vif802/stc32ESC/【文档】说明书 芯片手册 原理图 位号图等/代码审查报告.md

# STC32G 无刷电调代码审查报告

**审查日期：** 2026-03-10
**审查人：** Claude Code
**代码版本：** 逐飞科技 STC32G 无刷电调开源项目
**目标MCU：** STC32G12K128-LQFP48

---

## 一、项目架构评估

### 1.1 整体架构设计

| 评估项 | 评分 | 说明 |
|---|---|---|
| 模块化程度 | ⭐⭐⭐⭐☆ | 功能模块划分清晰，但存在文件命名冲突 |
| 代码组织结构 | ⭐⭐⭐☆☆ | 库文件和应用代码分层明确，但有命名重复问题 |
| 可维护性 | ⭐⭐⭐☆☆ | 注释较完整，但存在编码问题和魔法数字 |
| 安全性设计 | ⭐⭐⭐⭐☆ | 包含必要的保护机制（低压保护、堵转保护） |

### 1.2 目录结构

```
SEEKFREE_STC32G_BLDC/
├── bldc/                   # BLDC核心控制模块（良好）
│   ├── motor.c/h          # 电机控制核心
│   ├── pwm.c/h            # PWM生成
│   ├── comparator.c/h     # BEMF检测
│   ├── pwm_input.c/h      # 油门输入
│   ├── battery.c/h        # 电池监测
│   └── pit_timer.c/h      # 定时器/LED
├── Project/
│   ├── CODE/
│   │   ├── car_ctrl.c     # ⚠️ 智能车控制代码（与电调无关）
│   │   ├── motor.c/h      # ⚠️ 命名冲突！与 bldc/motor.c 重复
│   │   └── param_ctrl.c   # 参数控制
│   └── USER/src/
│       ├── main.c         # 主函数
│       └── isr.c          # 中断服务（部分为空）
└── Libraries/             # SDK和HAL库（标准）
```

### 1.3 严重问题：文件命名冲突

**问题描述：**
- `bldc/motor.c` 和 `Project/CODE/motor.c` 同时存在
- 两个文件都定义了 `motor_init()` 等函数
- 如果 include 路径配置不当，会导致链接错误或运行时错误

**影响程度：** 🔴 **高危**

**修复建议：**
```
方案1：将 Project/CODE/motor.c 重命名为 car_motor.c（智能车专用）
方案2：将 bldc/motor.c 重命名为 bldc_motor.c
方案3：删除 Project/CODE/ 下的智能车代码（如果只做电调）
```

---

## 二、核心模块详细审查

### 2.1 motor.c - 电机控制核心

**文件位置：** `bldc/motor.c`
**代码行数：** ~818行
**功能：** 实现三段式无传感器启动（预定位→开环→闭环）

#### ✅ 优点

1. **启动策略完善**
   - 实现了标准的三段式启动：预定位(Alignment) → 开环加速(Open-loop) → 闭环运行(Closed-loop)
   - 支持三种加速曲线：线性、指数、S曲线
   - 有过渡阶段确保平滑切换

2. **安全保护机制**
   ```c
   // 堵转检测 - 使用换相时间方差判断
   if(((max >> 1) > average) || ((min << 1) < average) || (15000 < max) || (100 > min))
   {
       motor.commutation_failed_num++;
   }

   // 超时保护 - Timer4检测换相超时
   if(BLDC_COMMUTATION_FAILED_MAX < motor.commutation_failed_num)
   {
       motor_stop();
       motor.restart_delay = BLDC_START_DELAY;
   }
   ```

3. **占空比斜坡控制**
   ```c
   void duty_ramp_up(void)  // 避免电流冲击
   ```

#### ⚠️ 问题与风险

**问题1：代码重复（低效）**

```c
// motor_max_min_pwm() 和 motor_max_min_comparator() 功能完全相同
void motor_max_min_pwm(uint16 *dat, uint8 length, uint16 *max, uint16 *min);      // 第179行
void motor_max_min_comparator(uint16 *dat, uint8 length, uint16 *max, uint16 *min); // 第209行
```

**建议：** 合并为一个函数 `motor_find_max_min()`

---

**问题2：魔法数字过多**

```c
// 第480-494行：这些数字缺乏注释说明
if(((max >> 1) > average) || ((min << 1) < average) || (15000 < max) || (100 > min))

// 第513行：65535 - average/4 的含义不明确
timer0_reconfig(65535 - average/4);

// 第627行：为什么用 %6 判断？
if(0 == (motor.commutation_num%6))
```

**建议：** 定义为有意义的常量
```c
#define COMMUTATION_TIME_MAX    15000   // 最大换相时间(us)
#define COMMUTATION_TIME_MIN    100     // 最小换相时间(us)
#define DEMAGNETIZATION_DIV     4       // 消磁时间分频系数
```

---

**问题3：潜在的除零风险**

```c
// 第480-482行
if((max > 0) && (min > 0))
{
    err_percent = ((max - min) * 100) / ((max + min) >> 1);  // 如果 max+min < 2，右移后=0，除零！
```

**风险：** 当 `max=0, min=1` 时，`(max+min) >> 1 = 0`，导致除零错误。

---

**问题4：死代码**

```c
// 第472-490行：这些变量计算后未实际使用
uint8 zc_quality_ok = 0;
uint16 err_percent = 0;
...
(void)zc_quality_ok;  // 显式标记已使用，消除警告
(void)err_percent;
```

说明：这段代码用于过零信号质量检测，但实际切换逻辑在TM3_Isr中。这是未完成的调试代码。

---

**问题5：启动阶段状态机不够清晰**

```c
// run_flag 和 start_phase 两个变量都表示阶段，容易混淆
motor.run_flag = 2;       // 开环加速阶段
motor.start_phase = 2;    // 同样表示开环阶段
```

**建议：** 统一使用一个状态变量

---

### 2.2 pwm.c - PWM生成

**文件位置：** `bldc/pwm.c`
**代码行数：** ~279行

#### ✅ 优点

1. **死区控制正确**
   ```c
   void pwm_a_bn_output(void)
   {
       pwm_close_output();   // 先关闭所有输出
       delay_500ns();        // 500ns死区延时
       PWMA_ENO = 1<<0;      // 再开启新的相
       PWM_B_L_PIN = 1;
       comparator_select_c(); // 同步切换比较器通道
   }
   ```

2. **中心对齐PWM配置正确**
   - 使用 PWM Mode 2
   - 预装载允许，避免PWM glitch

#### ⚠️ 问题与风险

**问题1：软延时不精确**

```c
void delay_500ns(void)
{
    _nop_();  // 8个nop，假设每个nop 62.5ns（16MHz），实际是500ns
    ...
}
```

**风险：** 系统频率改为33MHz后，实际延时变为约240ns，死区不足可能导致上下桥直通！

**建议：** 根据实际主频调整nop数量，或使用定时器实现精确延时。

---

**问题2：占空比更新方式有风险**

```c
void pwm_center_duty_update(uint16 duty)
{
    duty = BLDC_MAX_DUTY - duty;  // 反相计算
    // 直接更新CCR寄存器
    PWMA_CCR1H = temp_h;
    ...
}
```

**风险：** 在PWM周期中更新CCR可能导致glitch（毛刺）。

**建议：** 利用预装载机制，在PWM更新事件时自动加载新值。

---

### 2.3 comparator.c - BEMF检测

**文件位置：** `bldc/comparator.c`
**代码行数：** ~110行

#### ✅ 优点

1. **比较器配置正确**
   ```c
   CMPCR2 = 63;  // 63个时钟滤波，避免噪声干扰
   ```

2. **通道切换清晰**
   - 根据当前换相步骤切换比较器输入通道

#### ⚠️ 问题与风险

**问题1：中文注释严重乱码**

```c
// 第14行
//  @brief      姣旇緝鍣ㄩ€夋嫨A閫氶亾涓鸿緭鍏?
```

虽然不影响编译，但严重影响代码可读性。

---

### 2.4 pwm_input.c - 油门输入

**文件位置：** `bldc/pwm_input.c`
**代码行数：** ~110行

#### ✅ 优点

1. **输入信号校验完善**
   ```c
   // 频率检查：30-400Hz
   if((30 < pwmin.frequency) && (400 > pwmin.frequency))

   // 脉宽检查：1000-2000us
   if((3000 < pwmin.high_time) || (1000 > pwmin.high_time))
   ```

2. **分频系数设计合理**
   - PSC=32，使得计数值直接对应us（近似）

#### ⚠️ 问题与风险

**问题1：信号丢失处理有延迟**

```c
if(PWMB_SR1 & 0x01)  // 更新中断（信号丢失）
{
    PWMB_SR1 = 0;
    pwmin.throttle = 0;
    motor.duty = 0;  // 直接清零，可能导致电机突然停止
}
```

**风险：** PWM信号突然丢失时电机会立即停转，可能造成危险。

**建议：** 增加信号丢失超时检测，逐渐降低占空比。

---

**问题2：油门阈值计算有歧义**

```c
// 第59行
if(temp < ((uint32)1000 * BLDC_MIN_DUTY / BLDC_MAX_DUTY))
{
    temp = 0;
}
```

**问题：** 将占空比直接映射到油门阈值不合理，应该设置独立的油门死区参数。

---

### 2.5 battery.c - 电池监测

**文件位置：** `bldc/battery.c`
**代码行数：** ~57行

#### ✅ 优点

1. **分压电阻计算正确**
   ```c
   battery_voltage = (uint32)pin_voltage * 57 / 10;  // 分压比5.7:1
   ```

2. **低电压滤波处理**
   ```c
   // 连续100次检测到低电压才触发保护
   if(100 < low_power_num)
   ```

#### ⚠️ 问题与风险

**问题1：缺少过压保护**

只有低压保护，没有高压保护。如果误接6S电池到3S电调，可能损坏硬件。

---

**问题2：电压校准值硬编码**

```c
pin_voltage = (uint32)adc_value * 5000 / 256;  // 假设Vref=5V
```

**风险：** 实际Vref可能有偏差，应该支持校准。

---

### 2.6 pit_timer.c - 定时器/LED

**文件位置：** `bldc/pit_timer.c`
**代码行数：** ~146行

#### ✅ 优点

1. **LED状态指示清晰**
   - 不同run_flag对应不同闪烁模式
   - 便于调试和故障排查

2. **自动启动逻辑正确**
   ```c
   if(motor.duty && (0 == motor.run_flag))
   {
       motor_start();  // 有油门且电机停止时才启动
   }
   ```

#### ⚠️ 问题与风险

**问题1：中文注释严重乱码**

与comparator.c类似，编码问题导致注释不可读。

---

**问题2：停止逻辑有漏洞**

```c
else if((0 == motor.duty) && ((3 == motor.run_flag) || (4 == motor.run_flag)))
{
    motor_stop();  // 只在run_flag=3或4时停止
}
```

**风险：** 如果电机在启动阶段(run_flag=1或2)油门归零，不会立即停止。

**建议：**
```c
else if(0 == motor.duty)
{
    motor_stop();  // 只要有油门就停止，无论哪个阶段
}
```

---

## 三、应用层代码审查（Project/CODE/）

### 3.1 car_ctrl.c - 智能车控制

**状态：** ⚠️ **与BLDC电调功能无关**

这个文件实现的是智能车竞赛的控制逻辑：
- 编码器测速
- 速度PID
- 角速度PID
- 转向PID

**问题：** 这是智能车主控板的代码，不应该出现在无刷电调项目中。

**建议：** 如果只做电调，删除整个 Project/CODE/ 目录。

---

### 3.2 Project/CODE/motor.c

**状态：** ⚠️ **命名冲突**

这个文件实现的是智能车的直流电机控制（有刷电机），与 `bldc/motor.c` 完全不同。

**函数冲突列表：**
- `motor_init()` - 两者都有
- `motor_control()` - 两者都有

**风险：** 链接时可能链接错误的函数，导致电调无法工作。

---

## 四、编码质量问题汇总

### 4.1 严重问题（必须修复）

| 优先级 | 问题 | 位置 | 修复建议 |
|---|---|---|---|
| 🔴 P0 | 文件命名冲突 | Project/CODE/motor.c vs bldc/motor.c | 重命名其中一个 |
| 🔴 P0 | 死区延时不准确 | pwm.c:17 | 根据33MHz调整nop数量 |
| 🟡 P1 | 除零风险 | motor.c:482 | 增加除零保护 |
| 🟡 P1 | 停止逻辑漏洞 | pit_timer.c:108 | 修复为所有阶段都能停止 |

### 4.2 中等问题（建议修复）

| 优先级 | 问题 | 位置 | 修复建议 |
|---|---|---|---|
| 🟡 P1 | 代码重复 | motor.c:179,209 | 合并函数 |
| 🟡 P1 | 魔法数字 | motor.c:480-494 | 定义为常量 |
| 🟡 P1 | 死代码 | motor.c:472-490 | 删除或完成逻辑 |
| 🟢 P2 | 注释乱码 | 多处 | 重新保存为UTF-8 |

### 4.3 轻微问题（可选优化）

| 优先级 | 问题 | 位置 | 修复建议 |
|---|---|---|---|
| 🟢 P2 | 缺少过压保护 | battery.c | 增加高压检测 |
| 🟢 P2 | 信号丢失处理 | pwm_input.c:71 | 增加平滑过渡 |
| 🟢 P2 | 状态机重复 | motor.h | 统一状态变量 |

---

## 五、功能正确性评估

### 5.1 启动流程验证

```
[停止] → 预定位(Alignment) → 开环加速(Open-loop) → 过渡 → 闭环(Closed-loop)
   ↑                                                    ↓
   └──────────────── 堵转/停止 ──────────────────────────┘
```

**状态转换检查：** ✅ 逻辑正确

### 5.2 中断优先级配置

```c
// motor.c:807-812
IP |= 1<<7;     // 比较器中断 - 高优先级
IPH |= 1<<7;
IP2 |= 1<<5;    // PWM中断 - 高优先级
IP2H |= 1<<5;
```

**评估：** ✅ 关键中断（PWM、比较器）优先级正确

### 5.3 换相时序验证

换相表检查（6步换相）：
| Step | 上桥 | 下桥 | 检测相 | 沿 |
|---|---|---|---|-----|
| 0 | A | B | C | 下降沿 |
| 1 | A | C | B | 上升沿 |
| 2 | B | C | A | 下降沿 |
| 3 | B | A | C | 上升沿 |
| 4 | C | A | B | 下降沿 |
| 5 | C | B | A | 上升沿 |

**评估：** ✅ 换相表正确，BEMF检测相和沿匹配

---

## 六、性能评估

### 6.1 中断响应时间

| 中断源 | 优先级 | 执行时间(估算) | 风险 |
|---|---|---|---|
| PWM中断 | 高 | ~50us | 高频中断，占用较多CPU |
| 比较器中断 | 高 | ~30us | 只在闭环触发，可接受 |
| Timer1(10ms) | 低 | ~10us | 可接受 |
| Timer3 | 低 | ~20us | 只在启动触发，可接受 |

**评估：** 33MHz主频下，中断负载率约10-15%，可接受。

### 6.2 内存使用

```
Program Size: data=8.0 edata+hdata=1154 xdata=0 const=189 code=11613
```

- CODE: ~11.6KB (STC32G12K128有128KB Flash，充足)
- DATA: ~1.2KB (STC32G12K128有8KB RAM，充足)

**评估：** ✅ 资源使用合理

---

## 七、安全评估

### 7.1 硬件保护措施

| 保护功能 | 实现状态 | 评估 |
|---|---|---|
| 低压保护 | ✅ 已实现 | 10V阈值，100次滤波 |
| 过压保护 | ❌ 未实现 | 建议增加 |
| 过流保护 | ❌ 未实现 | 硬件需增加电流检测 |
| 堵转保护 | ✅ 已实现 | 基于换相时间方差 |
| 过热保护 | ❌ 未实现 | 需增加温度检测 |
| 启动超时 | ✅ 已实现 | BLDC_START_WAIT_TIME |

### 7.2 PWM安全

```c
// main.c:61-64 重要提醒！
// PWM初始化务必放在电机电机初始化函数之后，否则会烧毁电机
pwm_center_init();
```

**评估：** ✅ 初始化顺序要求明确，防止硬件损坏

---

## 八、可改进建议（优化方向）

### 8.1 代码优化

1. **使用查找表优化加速曲线**
   ```c
   // 当前：实时计算 Sigmoid
   delay = START_OPEN_LOOP_MIN_DELAY + ... * 1.0f/(1.0f + exp(...));

   // 优化：预计算查找表
   const uint16 accel_curve[100] = { ... };
   ```

2. **减少浮点运算**
   - 当前代码使用较多float运算
   - 定点数或整数运算可提升性能

### 8.2 功能扩展

1. **增加反向功能**
   - 当前只支持单向旋转
   - 可增加方向控制输入

2. **增加刹车模式**
   - 当前只有自由停车
   - 可增加能耗刹车或反接刹车

3. **增加参数可调**
   - 通过串口或按键调整PID参数
   - 实时修改启动曲线

---

## 九、测试建议

### 9.1 单元测试

| 测试项 | 测试方法 | 通过标准 |
|---|---|---|
| 预定位时间 | 示波器测量 | 与START_ALIGN_TIME_MS一致 |
| 开环加速曲线 | 逻辑分析仪 | 换相间隔逐渐减小 |
| 闭环切换 | 虚拟示波器 | zc_detect_count达到设定值后切换 |
| 堵转保护 | 手动堵转电机 | 150次错误后停止 |
| 低压保护 | 可调电源 | 10V以下停止，10.5V以上恢复 |

### 9.2 集成测试

1. **不同电机测试**
   - 不同KV值电机
   - 不同极对数电机

2. **不同负载测试**
   - 空载启动
   - 带载启动
   - 突加负载

3. **边界条件测试**
   - 最低启动电压
   - 最高工作电压
   - 最低/最高油门

---

## 十、总结

### 总体评价

| 维度 | 评分 | 说明 |
|---|---|---|
| 功能完整性 | ⭐⭐⭐⭐☆ | 三段式启动完善，保护功能齐全 |
| 代码质量 | ⭐⭐⭐☆☆ | 有编码问题和重复代码 |
| 安全性 | ⭐⭐⭐⭐☆ | 必要的保护都有，但缺少过压/过流 |
| 可维护性 | ⭐⭐⭐☆☆ | 需要解决命名冲突和注释问题 |
| 性能 | ⭐⭐⭐⭐☆ | 中断负载合理，资源使用合理 |

### 是否可以运行

**结论：** ✅ **可以运行，但需要先修复关键问题**

**必须修复后才能运行：**
1. 文件命名冲突（Project/CODE/motor.c）
2. 死区延时调整（pwm.c）

**建议修复：**
3. 除零风险（motor.c）
4. 停止逻辑漏洞（pit_timer.c）

### 是否符合项目规划

**评估：** ✅ 基本符合无刷电调的功能规划

**注意：** Project/CODE/ 目录下的智能车代码与电调功能无关，建议移除以避免混淆。

---

**报告结束**

如有任何疑问或需要针对特定问题的详细修复方案，请随时提出。
