vif802/stc32ESC/【文档】说明书 芯片手册 原理图 位号图等/编码转换问题修复记录.md

# 编码转换问题修复记录

## 问题概述

在使用 VSCode 进行文件编码格式转换时，由于处理不当导致源代码文件出现严重损坏，造成 Keil 编译失败。

**根本原因：** GBK 编码的中文注释被错误转换后，换行符丢失，导致代码结构被破坏。

---

## 错误现象

### 编译错误信息

```
compiling motor.c...
..\..\bldc\motor.c(85): error C70: duty_ramp_timer: undefined member
..\..\bldc\motor.c(86): error C70: duty_ramp_timer: undefined member
..\..\bldc\motor.c(88): error C70: duty_ramp_timer: undefined member
..\..\bldc\motor.c(338): error C70: start_phase: undefined member
..\..\bldc\motor.c(340): error C70: duty_ramp_timer: undefined member
..\..\bldc\motor.c(572): error C25: syntax error near 'void'
...
```

**错误类型：**
- `error C70: undefined member` - 结构体成员未定义
- `error C25: syntax error` - 语法错误
- `error C53: redefinition` - 函数重复定义

---

## 问题分析

### 受损文件列表

| 文件路径 | 损坏类型 | 严重程度 |
|---|---|---|
| `bldc/motor.h` | 结构体定义换行丢失 | 严重 |
| `bldc/motor.c` | 函数结构错乱、重复定义 | 严重 |
| `bldc/pwm_input.c` | 中文注释乱码 | 轻微 |
| `bldc/pit_timer.c` | 中文注释乱码 | 轻微 |

### 损坏详情

#### 1. motor.h 结构体定义损坏

**损坏前（正确代码）：**
```c
typedef struct
{
    uint8   step;                   // 电机运行的步数
    uint16  duty;                   // PWM占空比 用户改变电机速度时修改此变量
    uint16  duty_register;          // PWM占空比寄存器 用户不可操作
    vuint8  run_flag;               // 电机正在运行标志位
    ...
}motor_struct;
```

**损坏后（错误代码）：**
```c
typedef struct
{
    uint8   step;                   // 鐢垫満杩愯鐨勬楠?    uint16  duty;                   // PWM鍗犵┖姣?      鐢ㄦ埛鏀瑰彉鐢垫満閫熷害鏃朵慨鏀规鍙橀噺
    ...
}motor_struct;
```

**问题：** 换行符丢失，`uint16 duty` 等成员被吞进了上一行的注释中，编译器无法识别这些结构体成员。

#### 2. motor.c 函数结构损坏

**损坏前（正确代码）：**
```c
            }
        }
    }

}

//-------------------------------------------------------------------------------------------------------------------
//  @brief      比较器中断函数
//  @param      void
//  @return     void
//  @since      v1.0
//  Sample usage:
//-------------------------------------------------------------------------------------------------------------------
void comparator_isr(void) interrupt 21
{
```

**损坏后（错误代码）：**
```c
                // ========== 预定位阶段(Stage 1): 不检测过零 ==========
                // run_flag=1时不处理过零信号，等待定时器3进入开环阶段            }  // <-- 右大括号被吞进注释
        }
    }

}

// ... 第一个残缺的 comparator_isr 定义
void comparator_isr(void) interrupt 21
{
        }  // <-- 多余的括号
    }

}

// ... 第二个重复的 comparator_isr 定义
void comparator_isr(void) interrupt 21
{
```

**问题：**
1. 右大括号 `}` 被吞进注释，导致函数提前结束
2. 产生了残缺的函数代码块
3. 出现了重复的函数定义

---

## 修复方法

### 修复步骤

#### 步骤 1：修复 motor.h 结构体定义

**文件：** `SEEKFREE_STC32G_BLDC/bldc/motor.h`

**操作：** 重新格式化整个结构体定义，确保每个成员单独一行，注释正确换行。

```c
typedef struct
{
    uint8   step;                   // 电机运行的步数
    uint16  duty;                   // PWM占空比 用户改变电机速度时修改此变量
    uint16  duty_register;          // PWM占空比寄存器 用户不可操作
    vuint8  run_flag;               // 电机正在运行标志位
                                    // 0:已停止
                                    // 1：预定位阶段(Alignment)
                                    // 2：开环加速阶段(Open-loop)
                                    // 3：切入闭环过渡阶段
                                    // 4：启动完成正在运行(Closed-loop)
    uint8   degauss_flag;           // 0：消磁完成 2：换相完成，正在延时消磁
    float   motor_start_delay;      // 开环启动的换相的延时时间
    uint16  motor_start_wait;       // 开环启动时，换相时间已经降低到最小值后，统计换相的次数
    uint16  restart_delay;          // 电机延时重启
    uint16  commutation_failed_num; // 换相错误次数
    uint16  commutation_time[6];    // 最近6次换相时间
    uint32  commutation_time_sum;   // 最近6次换相时间总和
    uint32  commutation_num;        // 统计换相次数

    // 三段式启动新增参数
    uint16  align_duty;             // 预定位占空比
    uint16  target_duty;            // 目标占空比 开环阶段逐步增加到此值

    uint8   zc_detect_count;        // 过零信号检测计数
    uint8   start_phase;            // 启动阶段 0:未启动 1:预定位 2:开环 3:过渡 4:闭环
    uint16  open_loop_step;         // 开环加速步数计数
    uint16  duty_ramp_timer;        // 占空比斜坡定时器
}motor_struct;
```

#### 步骤 2：修复 motor.c 函数结构

**文件：** `SEEKFREE_STC32G_BLDC/bldc/motor.c`

**操作：**

1. **修复第 560 行：** 将右大括号从注释中分离出来

```c
                // ========== 预定位阶段(Stage 1): 不检测过零 ==========
                // run_flag=1时不处理过零信号，等待定时器3进入开环阶段
            }  // <-- 单独一行
```

2. **删除重复代码（第 567-587 行）：** 删除残缺的函数定义和重复的 `comparator_isr`

```c
// 删除以下内容：
//-------------------------------------------------------------------------------------------------------------------
//  @brief      比较器中断函数
//  @param      void
//  @return     void
//  @since      v1.0
//  Sample usage:
//-------------------------------------------------------------------------------------------------------------------
void comparator_isr(void) interrupt 21
{
        }
    }

}

//-------------------------------------------------------------------------------------------------------------------
//  @brief      比较器中断函数//  @param      void
...
```

只保留一个完整正确的 `comparator_isr` 函数定义。

---

## 修复结果

### 编译输出

```
Build started: Project: STC32G
Build target 'STC32G12K128_BLDC_HALLESS'
compiling motor.c...
..\..\bldc\motor.c(490): warning C138: expression with possibly no effect
..\..\bldc\motor.c(52): warning C177: unreachable code
..\..\bldc\motor.c(65): warning C177: unreachable code
...
linking...
Program Size: data=8.0 edata+hdata=1154 xdata=0 const=189 code=11613
creating hex file from ".\Out_File\SEEKFREE"...
".\Out_File\SEEKFREE" - 0 Error(s), 18 Warning(s).
Build Time Elapsed:  00:00:00
```

**结果：** 0 个错误，18 个警告（警告为代码优化提示，不影响程序运行）

---

## 预防措施

### 避免编码转换问题的建议

1. **备份原始文件**
   - 在进行任何编码转换操作前，先备份整个项目
   - 使用 Git 等版本控制工具

2. **使用正确的编码转换工具**
   - 推荐使用专门的编码转换工具，如 Notepad++
   - 在 VSCode 中，使用 "Reopen with Encoding" 而不是直接转换

3. **验证转换结果**
   - 转换后立即编译检查
   - 对比文件行数是否一致
   - 检查关键结构（如结构体、函数定义）是否完整

4. **设置 Keil 编码**
   - 在 Keil 中设置正确的编辑器编码：Edit → Configuration → Editor → Encoding
   - 建议使用 UTF-8 或 GB2312

### 推荐的文件编码设置

| 文件类型 | 推荐编码 |
|---|---|
| C 源文件 | UTF-8 with BOM 或 GB2312 |
| 头文件 | UTF-8 with BOM 或 GB2312 |
| 文档 | UTF-8 |

---

## 相关文件备份

修复前的原始损坏文件已备份至：
- （如有备份，请在此记录备份位置）

---

## 附录：常见编码转换错误特征

| 错误现象 | 可能原因 | 解决方法 |
|---|---|---|
| 中文注释乱码 | 编码识别错误 | 用正确编码重新打开文件 |
| 换行符丢失 | 编码转换时处理换行符错误 | 手动修复换行 |
| 代码被吞进注释 | 注释换行符丢失 | 手动分离代码和注释 |
| 结构体成员未定义 | 成员声明被合并到注释行 | 重新格式化结构体定义 |
| 函数重复定义 | 代码块错乱导致重复 | 删除重复代码块 |

---

**记录时间：** 2026-03-10
**修复人：** Claude Code
**审核状态：** 已验证编译通过
