vif802/stc32ESC/硬件设计说明与采购清单.md

# STC32G12K128 无感无刷电调硬件设计说明与采购清单

## 一、系统架构

### 1.1 整体框图

```
3S锂电池(11.1V/12.6V)
    │
    ├──→ 电源管理模块 ──→ SE8650K1-HF ──→ 5V/3.3V
    │                                    │
    └──→ 三相半桥驱动 ──→ FD6288Q ──→ TPN2R203NC ×6 ──→ 无刷电机
                │
                └──→ BEMF分压检测 ──→ STC32G12K128比较器

控制信号(PWM 1-2ms) ──→ STC32G12K128 ──→ FD6288Q
```

### 1.2 功能模块划分

| 模块 | 功能说明 | 核心器件 |
|---|---|---|
| 主控单元 | 电机控制算法、PWM生成、BEMF检测 | STC32G12K128-LQFP48 |
| 栅极驱动 | 6路PWM信号放大、高低侧驱动 | FD6288Q |
| 功率开关 | 三相半桥功率MOSFET | TPN2R203NC ×6 |
| 电源管理 | 电池电压转5V/3.3V | SE8650K1-HF + LDO |
| 信号输入 | PWM控制信号接收 | 光耦隔离或直接输入 |
| BEMF检测 | 反电动势分压与虚拟中性点 | 电阻网络 |
| 保护电路 | 过流、欠压、过温保护 | 比较器+采样电阻 |

---

## 二、详细电路设计

### 2.1 主控电路 (STC32G12K128)

#### 2.1.1 最小系统

```
                     VCC(3.3V)
                      │
                     C1│C2
                     10µF│100nF
                      │   │
                      └───┴──→ VCC
                              │
         ┌────────────────────┼────────────────────┐
         │     STC32G12K128   │                    │
         │    ┌───────────┐   │                    │
P5.5 ────┼──→ │RST        │   │                    │
(复位)   │    │           │   │                    │
         │    │P20-P25    │←──┼──→ FD6288Q (PWM)  │
         │    │ (PWM输出) │   │                    │
         │    │           │   │                    │
         │    │P30-P32    │←──┼──→ BEMF输入        │
         │    │ (比较器)   │   │                    │
         │    │           │   │                    │
         │    │P54        │←──┼──→ 复位/ISP        │
         │    │           │   │                    │
         │    │P3.0/P3.1  │←──┼──→ UART (调试)    │
         │    └───────────┘   │                    │
         └────────────────────┼────────────────────┘
                              │
                     GND──────┘
```

#### 2.1.2 引脚分配表

| 引脚 | 功能 | 连接对象 | 说明 |
|---|---|---|---|
| P20 | PWMA_CH1P | FD6288Q HIN1 | A相高侧PWM |
| P21 | PWMA_CH1N | FD6288Q LIN1 | A相低侧PWM |
| P22 | PWMA_CH2P | FD6288Q HIN2 | B相高侧PWM |
| P23 | PWMA_CH2N | FD6288Q LIN2 | B相低侧PWM |
| P24 | PWMA_CH3P | FD6288Q HIN3 | C相高侧PWM |
| P25 | PWMA_CH3N | FD6288Q LIN3 | C相低侧PWM |
| P30 | CMP+ | BEMF_A | A相反电动势 |
| P31 | CMP+ | BEMF_B | B相反电动势(复用) |
| P32 | CMP+ | BEMF_C | C相反电动势(复用) |
| P33 | CMP- | VIRTUAL_NEUTRAL | 虚拟中性点 |
| P34 | ADC | VBAT/11 | 电池电压检测 |
| P35 | GPIO | LED_STATUS | 状态指示灯 |
| P36 | GPIO | BEEP | 蜂鸣器 |
| P54 | RST | 复位电路 | 系统复位 |

---

### 2.2 栅极驱动电路 (FD6288Q)

#### 2.2.1 原理图

```
                    VCC(12V)
                     │
                    C3│C4
                   10µF│100nF
                     │   │
                     └───┴──→ VBS
                             │
        ┌────────────────────┼────────────────────┐
        │      FD6288Q       │                    │
        │    ┌───────────┐   │                    │
STC     │    │           │   │                    │
P20 ────┼──→ │HIN1       │←──┼──→ HO1 ──→ A相高侧MOS│
        │    │           │   │                    │
P21 ────┼──→ │LIN1       │←──┼──→ LO1 ──→ A相低侧MOS│
        │    │           │   │                    │
P22 ────┼──→ │HIN2       │←──┼──→ HO2 ──→ B相高侧MOS│
        │    │           │   │                    │
P23 ────┼──→ │LIN2       │←──┼──→ LO2 ──→ B相低侧MOS│
        │    │           │   │                    │
P24 ────┼──→ │HIN3       ││←──┼──→ HO3 ──→ C相高侧MOS│
        │    │           │   │                    │
P25 ────┼──→ │LIN3       ││←──┼──→ LO3 ──→ C相低侧MOS│
        │    │           │   │                    │
        │    │ITRIP      │←──┼──→ 过流保护(可选)   │
        │    └───────────┘   │                    │
        └────────────────────┼────────────────────┘
                             │
                    GND──────┘
```

#### 2.2.2 关键参数

| 参数 | 值 | 说明 |
|---|-----|---|
| 输入电压 | 6.5V-20V | 驱动供电电压 |
| 输出电流 | +1300mA/-1500mA | 栅极驱动能力 |
| 死区时间 | 200ns-300ns | 内置死区保护 |
| 工作频率 | 高达500kHz | PWM频率支持 |

---

### 2.3 三相半桥功率电路

#### 2.3.1 拓扑结构

```
VBAT (11.1V-12.6V)
  │
  ├──┬─────────┬─────────┐
  │  │         │         │
  │  │         │         │
 ┌┴──┴┐      ┌┴──┴┐     ┌┴──┴┐
 │AH  │      │BH  │     │CH  │  ← 高侧MOS (TPN2R203NC)
 │    │      │    │     │    │
 └──┬─┘      └──┬─┘     └──┬─┘
    │A         │B        │C         ← 电机相线输出
   ─┴─         ─┴─        ─┴─
   ╱ ╲         ╱ ╲        ╱ ╲        ← 无刷电机
   ╲ ╱         ╲ ╱        ╲ ╱
   ─┬─         ─┬─        ─┬─
    │           │          │
 ┌──┴─┐      ┌──┴─┐     ┌──┴─┐
 │AL  │      │BL  │     │CL  │  ← 低侧MOS (TPN2R203NC)
 │    │      │    │     │    │
 └──┬─┘      └──┬─┘     └──┬─┘
    │           │          │
    └───────────┴──────────┘
                  │
                 GND
```

#### 2.3.2 BEMF检测电路

```
         A相输出 ──→┬─── R1(10k) ──┬───→ P30 (CMP+)
                    │              │
                    │             C5(10nF)
                    │              │
         B相输出 ──→┼─── R2(10k) ──┼───→ P31 (CMP+)
                    │              │
                    │             C6(10nF)
                    │              │
         C相输出 ──→┴─── R3(10k) ──┴───→ P32 (CMP+)
                                   │
                                  R4(1k)
                                   │
                         P33 ──────┴─────┐
                         (CMP-)           │
                                    虚拟中性点
```

**BEMF检测原理：**
- 使用三个10kΩ电阻构成分压网络，将电机相电压分压至MCU可承受范围(0-3.3V)
- 三个10kΩ电阻并联形成虚拟中性点
- 比较器正端接分压后的相电压，负端接虚拟中性点
- 通过检测过零事件判断换相时机

---

### 2.4 电源管理电路

#### 2.4.1 系统电源架构

```
VBAT (11.1V-12.6V)
    │
    ├──→ SE8650K1-HF ──→ +5V ──→ AMS1117-3.3 ──→ +3.3V
    │        │              │
    │       C7             C8
    │      22µF          10µF
    │                      │
    └──→ FD6288Q驱动供电    └──→ STC32G12K128供电
```

#### 2.4.2 SE8650K1-HF 应用电路

```
        VIN (VBAT)
          │
         C9│C10
        10µF│100nF
          │   │
          └───┴──→ VIN (Pin1)
                    │
        ┌───────────┼───────────┐
        │  SE8650K1 │           │
        │    ┌──────┴──────┐    │
        │    │1 VIN   GND 3│←───┼──→ GND
        │    │             │    │
        │    │2 EN    VOUT 4│←───┼──→ +5V
        │    └─────────────┘    │
        └───────────────────────┘
                    │
                   C11
                  10µF
                    │
                   GND
```

**SE8650K1-HF参数：**
| 参数 | 值 | 说明 |
|---|-----|---|
| 输入电压 | 4.5V-36V | 宽压输入，支持3S锂电 |
| 输出电压 | 5V | 固定输出 |
| 输出电流 | 1A | 持续输出 |
| 静态电流 | 1.5mA | 低功耗 |
| 封装 | SOT-89-3 | 小封装 |

---

### 2.5 电池电压检测电路

```
VBAT (11.1V-12.6V)
    │
   R5(10k)
    │
    ├──→ P34 (ADC)
    │
   R6(1k)
    │
   GND

分压比：1k/(10k+1k) = 1/11
3S满电12.6V → ADC输入1.145V
3S欠压9V    → ADC输入0.818V
```

---

### 2.6 控制信号输入电路

#### 2.6.1 PWM输入（光耦隔离方案，推荐）

```
PWM输入(1-2ms)
    │
    ├─→ R7(330Ω) ──→┬──→ 光耦PC817输入侧
    │                │
    │               D1(1N4148)
    │                │
    └────────────────┘
                     │
                    GND

光耦PC817输出侧：
VCC(3.3V)
    │
   R8(10k)
    │
    ├──→ P36 (定时器输入捕获)
    │
光耦输出
    │
   GND
```

#### 2.6.2 直接输入方案（简化版）

```
PWM输入(1-2ms, 5V电平)
    │
   R9(10k) ──→┬──→ P36
    │          │
   C12         │
  100pF        │
    │          │
   GND         │
               │
内部上拉 ──────┘
```

---

### 2.7 保护与指示电路

#### 2.7.1 过流保护（可选）

```
    A相低侧源极
        │
   R10(0.01Ω)
        │
       GND
        │
        ├──→ 运放放大 ──→ P37 (ADC/比较器)
```

#### 2.7.2 LED状态指示

```
VCC(3.3V)
    │
   R11(1k)
    │
   LED1(绿色)
    │
   P35 ──→ MCU控制
    │
   GND
```

---

## 三、PCB Layout 设计要点

### 3.1 布局原则

```
┌─────────────────────────────────────────┐
│              PCB顶层（元件面）            │
├─────────────────────────────────────────┤
│                                         │
│  ┌─────────┐                           │
│  │STC32G128│        ┌─────┐            │
│  │  MCU    │        │FD6288│           │
│  └─────────┘        │ Q    │            │
│                     └─────┘            │
│  ┌─────┐                               │
│  │SE8650│                               │
│  └─────┘     ┌──────────────────┐      │
│              │   三相半桥        │      │
│  ┌─────┐     │  ┌──┬──┬──┐      │      │
│  │输入 │     │  │A │B │C │      │      │
│  │接口 │     │  └──┴──┴──┘      │      │
│  └─────┘     │                  │      │
│              └──────────────────┘      │
│                                         │
└─────────────────────────────────────────┘
```

### 3.2 关键Layout规则

| 项目 | 要求 | 原因 |
|---|---|---|
| 大电流路径 | 短而粗 | 降低EMI和发热 |
| 栅极驱动线 | 等长，<2cm | 保证死区一致 |
| 功率地与信号地 | 单点连接 | 防止地弹干扰 |
| BEMF检测线 | 远离PWM线 | 避免干扰 |
| 去耦电容 | 紧贴芯片引脚 | 有效滤波 |

---

## 四、完整物料清单 (BOM)

### 4.1 核心器件清单

| 序号 | 位号 | 型号 | 描述 | 数量 | 参考单价(元) | 采购渠道 |
|---|---|---|---|---|---|---|
| 1 | U1 | STC32G12K128-LQFP48 | 32位8051主控，35MHz | 1 | 8-12 | 立创商城/淘宝 |
| 2 | U2 | FD6288Q | 三相栅极驱动芯片，QFN-24 | 1 | 3-5 | 立创商城 |
| 3 | U3 | SE8650K1-HF | 5V/1A降压稳压器，SOT-89 | 1 | 1-2 | 立创商城 |
| 4 | Q1-Q6 | TPN2R203NC | N沟道MOS，30V/20A，PDFN3.3×3.3 | 6 | 2-3 | 立创商城 |

### 4.2 无源器件清单

| 序号 | 位号 | 型号/参数 | 描述 | 数量 | 封装 | 参考单价(元) |
|---|---|---|---|---|---|---|
| 5 | C1,C7,C9,C11 | 10µF/16V | 电解电容/MLCC | 4 | 0805/1206 | 0.1-0.3 |
| 6 | C2,C4,C6,C8,C10 | 100nF/25V | 陶瓷电容 | 5 | 0603 | 0.05 |
| 7 | C5,C6 | 10nF/50V | BEMF滤波电容 | 2 | 0603 | 0.05 |
| 8 | C12 | 100pF/50V | 高频滤波 | 1 | 0603 | 0.05 |
| 9 | R1-R3 | 10kΩ/1% | BEMF分压电阻 | 3 | 0603 | 0.02 |
| 10 | R4 | 1kΩ/1% | 中性点电阻 | 1 | 0603 | 0.02 |
| 11 | R5 | 10kΩ/1% | 电池分压 | 1 | 0603 | 0.02 |
| 12 | R6 | 1kΩ/1% | 电池分压 | 1 | 0603 | 0.02 |
| 13 | R7 | 330Ω | 光耦限流 | 1 | 0603 | 0.02 |
| 14 | R8 | 10kΩ | 上拉电阻 | 1 | 0603 | 0.02 |
| 15 | R9 | 10kΩ | 输入限流 | 1 | 0603 | 0.02 |
| 16 | R11 | 1kΩ | LED限流 | 1 | 0603 | 0.02 |
| 17 | R10(可选) | 0.01Ω/1% | 采样电阻 | 1 | 1206 | 0.5 |

### 4.3 接口与保护器件

| 序号 | 位号 | 型号 | 描述 | 数量 | 参考单价(元) |
|---|---|---|---|---|---|
| 18 | J1 | XT60-M | 电源输入接口 | 1 | 2-3 |
| 19 | J2 | 2.54mm-3P | 电机输出接口 | 1 | 0.5 |
| 20 | J3 | 2.54mm-3P | PWM信号输入 | 1 | 0.5 |
| 21 | D1 | 1N4148W | 开关二极管 | 1 | 0.1 |
| 22 | LED1 | 绿色LED | 状态指示 | 1 | 0.1 |
| 23 | U4(可选) | PC817 | 光耦隔离 | 1 | 0.3 |
| 24 | U5(可选) | AMS1117-3.3 | 3.3V LDO | 1 | 0.5 |

### 4.4 PCB及结构件

| 序号 | 名称 | 规格 | 数量 | 参考单价(元) |
|---|---|---|---|---|
| 25 | PCB | 双层板，FR4，1.6mm，沉金 | 1 | 15-30(打样5片) |
| 26 | 散热器 | 铝散热片，20×20×10mm | 1 | 2-5 |
| 27 | 导热硅脂/垫 | - | 1 | 1 |
| 28 | M2螺丝/铜柱 | 固定用 | 若干 | 1 |

---

## 五、成本预算

### 5.1 单板成本估算

| 类别 | 估算成本(元) |
|---|---|
| 核心器件 | 25-35 |
| 无源器件 | 3-5 |
| 接口与保护 | 5-8 |
| PCB(单片分摊) | 5-10 |
| 结构件 | 3-5 |
| **合计** | **41-63元/片** |

### 5.2 开发调试预算

| 项目 | 预算(元) |
|---|---|
| 打样PCB 5片 | 75-150 |
| 元器件(5套) | 200-300 |
| 测试电机 | 30-80 |
| STC烧录器 | 20-50 |
| 示波器/逻辑分析仪(借用或租赁) | - |
| **开发总预算** | **325-580元** |

---

## 六、采购渠道推荐

### 6.1 线上采购平台

| 平台 | 优势 | 适合采购 |
|---|---|---|
| **立创商城(lceda.cn)** | 正品保障， datasheet全 | 芯片、MOS、电阻电容 |
| **淘宝/天猫** | 价格灵活，种类多 | 模块、工具、结构件 |
| **京东** | 物流快 | 急用物料 |
| **贸泽/得捷** | 进口器件全 | 缺货型号 |

### 6.2 关键器件采购链接参考

1. **STC32G12K128-LQFP48**
   - 立创商城：搜索"STC32G12K128"
   - 价格：约8-12元

2. **FD6288Q**
   - 立创商城：搜索"FD6288Q"
   - 价格：约3-5元

3. **TPN2R203NC**
   - 立创商城：搜索"TPN2R203NC"
   - 注意：确认封装为PDFN3.3×3.3
   - 替代型号：TPN2R703NL(项目原配)

4. **SE8650K1-HF**
   - 立创商城/淘宝
   - 替代型号：AMS1117-5.0(需注意压差)

---

## 七、设计检查清单

### 7.1 原理图检查

- [ ] 所有器件位号唯一
- [ ] 电源网络命名正确(VBAT, +5V, +3.3V)
- [ ] 地网络区分功率地和信号地
- [ ] 去耦电容靠近芯片放置
- [ ] BEMF分压比正确(1/11)
- [ ] PWM引脚连接正确

### 7.2 PCB检查

- [ ] 大电流路径宽度≥2mm(1oz铜厚)
- [ ] 栅极驱动线等长
- [ ] MOS管散热焊盘打孔
- [ ] 安装孔位置正确
- [ ] 丝印清晰可读

### 7.3 装配检查

- [ ] 芯片方向正确
- [ ] 极性元件方向(电容、二极管)
- [ ] 散热片安装紧固
- [ ] 无虚焊、短路

---

## 八、注意事项

1. **MOS管代换**：TPN2R203NC与TPN2R703NL引脚兼容，但耐压/电流不同，确认满足电机功率需求
2. **电源热设计**：SE8650K1-HF在大压差时发热大，建议VBAT<16V使用或加散热
3. **烧录注意**：STC32G需要冷启动下载，先断电→点击下载→上电
4. **安全注意**：3S锂电短路危险，测试时做好绝缘保护
5. **电机匹配**：确认电机KV值与电调PWM频率匹配
