vif802/stc32ESC/【文档】说明书 芯片手册 原理图 位号图等/STC电调程序流程图.pdf

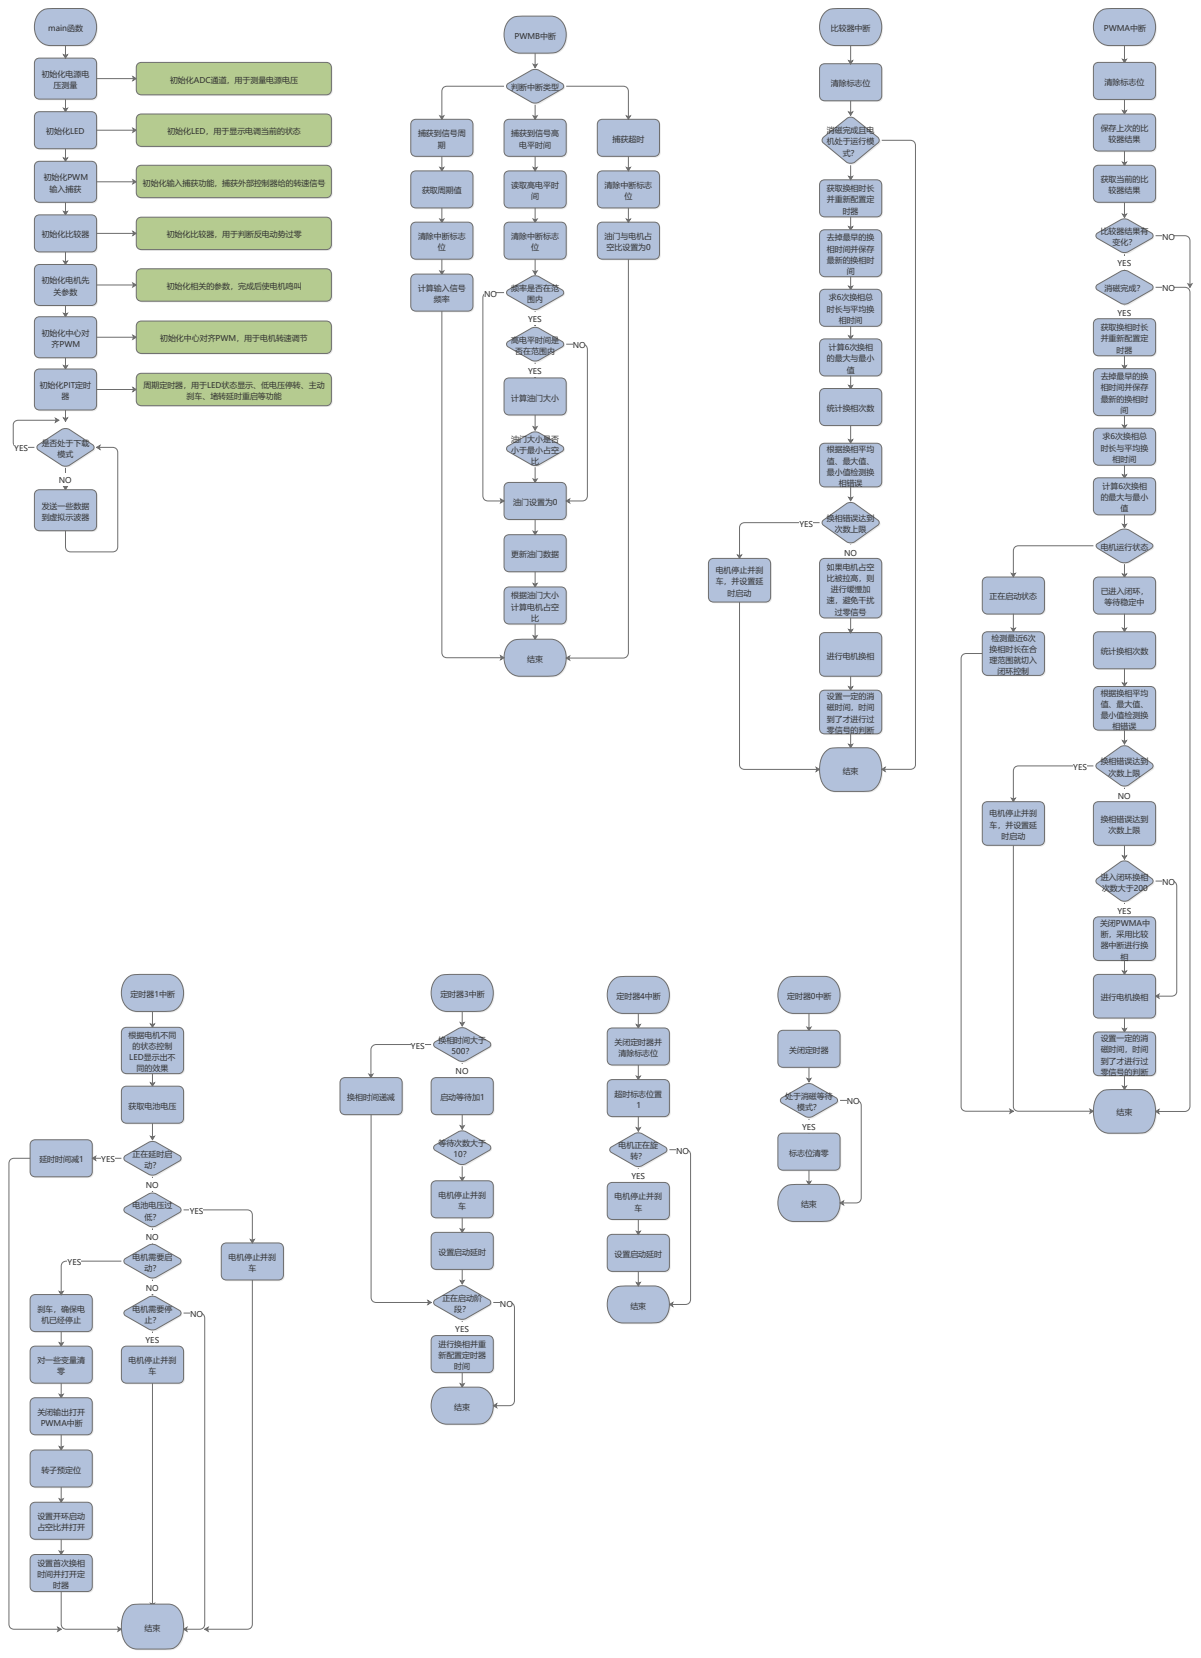
[picture p23: page 1]
更新油门数据; 初始化电源电 压测量; 初始化LED; 初始化PWM 输入捕获; main函数; 初始化比较器; 初始化电机先 关参数; 初始化中心对 齐PWM; 初始化PIT定时 器; 是否处于下载 模式; 发送一些数据 到虚拟示波器; 初始化输入捕获功能，捕获外部控制器给的转速信号; 初始化LED，用于显示电调当前的状态; 初始化ADC通道，用于测量电源电压; 初始化比较器，用于判断反电动势过零; 初始化相关的参数，完成后使电机鸣叫; 初始化中心对齐PWM，用于电机转速调节; 刹车、堵转延时重启等功能; 定时器1中断; PWMA中断; PWMB中断; 捕获到信号高 电平时间; 读取高电平时 间; 清除中断标志 位; 频率是否在范 围内; YES; 高电平时间是 否在范围内; 计算油门大小; 油门大小是否 小于最小占空 比; 油门设置为0; 判断中断类型; 比较器中断; 定时器3中断; 定时器4中断; 定时器0中断; 捕获超时 捕获到信号周 期; 获取周期值; 计算输入信号 频率; 油门与电机占 空比设置为0; 根据油门大小 计算电机占空 比; 正在延时启 动？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

周期定时器，用于LED状态显示、低电压停转、主动
