vif802/stc32ESC/(list of files, drawings)

Other design files:
【封装】集成封装库/无刷驱动-STC-无感-Lite3S.PcbLib
【封装】集成封装库/无刷驱动-STC-无感-Lite3S.SchLib
