vif802/stc32ESC/SEEKFREE_STC32G_BLDC/bldc/bldc_config.h

#ifndef _bldc_config_h_
#define _bldc_config_h_



#define BLDC_MAX_DUTY                   750     // PWM锟斤拷锟斤拷锟秸硷拷毡龋锟斤拷锟揭拷锟斤拷懈锟斤拷锟絇WM锟斤拷始锟斤拷去锟斤拷锟斤拷 锟斤拷锟侥革拷协锟斤拷锟绞碉拷锟斤拷锟斤拷锟斤拷锟竭碉拷占锟秸比ｏ拷锟斤拷锟斤拷锟斤拷锟斤拷锟斤拷锟劫度凤拷围

#define BLDC_MIN_DUTY                   50      // PWM锟斤拷锟斤拷小占锟秸比ｏ拷锟斤拷锟斤拷锟斤拷锟斤拷锟斤拷锟脚达拷小锟斤拷锟斤拷锟斤拷锟斤拷锟秸硷拷毡锟叫★拷诖硕锟斤拷锟斤拷锟斤拷锟酵Ｗ?锟斤拷锟斤拷要锟斤拷锟斤拷50

#define BLDC_START_VOLTAGE              1.0f    // 0-1.5 锟斤拷位V  锟斤拷锟侥革拷协锟斤拷锟斤拷锟斤拷锟斤拷偷锟窖癸拷锟斤拷锟斤拷锟斤拷锟斤拷锟斤拷锟斤拷俣锟斤拷锟斤拷锟

#define BLDC_MIN_BATTERY                10.0f   // 锟斤拷小锟斤拷压锟斤拷锟斤拷锟斤拷獾斤拷锟窖癸拷锟斤拷诖锟街碉拷锟斤拷停转 3S锂碉拷10V锟斤拷应3.33V/锟斤拷

#define BLDC_COMMUTATION_FAILED_MAX     150     // 锟斤拷锟斤拷锟斤拷锟斤拷锟斤拷锟斤拷锟?锟斤拷锟斤拷锟斤拷锟斤拷锟斤拷锟斤拷锟斤拷锟轿拷锟斤拷锟斤拷转 锟斤拷锟侥革拷协锟斤拷锟斤拷锟斤拷锟斤拷俜锟接︼拷锟斤拷锟斤拷锟轿?50

#define BLDC_START_DELAY                50      // 锟斤拷锟斤拷锟斤拷锟斤拷转锟斤拷锟斤拷停止时锟戒，之锟斤拷锟斤拷锟斤拷锟劫次筹拷锟斤拷锟斤拷锟斤拷锟斤拷锟斤拷位10ms锟斤拷 锟斤拷锟侥革拷协锟斤拷锟斤拷为50锟斤拷0.5锟诫）
#define BLDC_START_WAIT_TIME          15      // 锟斤拷锟斤拷锟饺达拷锟斤拷锟斤拷 锟斤拷位10ms 锟斤拷锟侥革拷协锟斤拷锟斤拷锟皆等达拷锟斤拷锟教讹拷时锟斤拷

#define BLDC_BEEP_ENABLE                1       // 1:使锟斤拷锟较碉拷锟斤拷锟斤拷锟叫癸拷锟斤拷 0锟斤拷锟斤拷锟斤拷

#define BLDC_BEEP_VOLUME                30      // 锟斤拷锟斤拷锟斤拷锟斤拷锟斤拷锟斤拷锟叫?0-100


// ============================================================================
// 锟斤拷锟斤拷式锟斤拷锟街诧拷锟斤拷锟斤拷锟斤拷 - 锟斤拷原锟叫憋拷锟斤拷锟斤拷筛慕锟?// ============================================================================

// 锟斤拷一锟轿ｏ拷锟斤拷位锟阶讹拷 (Pre-positioning)
#define START_ALIGN_DUTY_RATIO          0.5f    // 锟斤拷位占锟秸憋拷系锟斤拷(锟斤拷锟节讹拷始占锟秸憋拷锟侥憋拷锟斤拷)  锟斤拷围0.3-0.7
#define START_ALIGN_TIME_MS             300     // 锟斤拷位时锟斤拷(锟斤拷锟斤拷)  锟斤拷围200-500ms

// 锟节讹拷锟轿ｏ拷锟斤拷锟斤拷锟劫阶讹拷 (Open-loop Acceleration)
#define START_OPEN_LOOP_MIN_DELAY       200     // 锟斤拷小锟斤拷锟斤拷锟斤拷时(锟斤拷锟诫级)  锟斤拷锟斤拷转锟斤拷姆锟街
#define START_OPEN_LOOP_MAX_DELAY       3500    // 锟斤拷锟节伙拷锟斤拷锟斤拷锟?锟斤拷锟诫级)  锟斤拷一锟斤拷时时锟斤拷
#define START_OPEN_LOOP_STEP_NUM        100     // 锟斤拷锟斤拷锟斤拷锟劫诧拷锟斤拷  锟斤拷位锟斤拷锟斤拷锟斤拷锟斤拷越平锟斤拷
#define START_OPEN_LOOP_ACCEL_CURVE     2       // 锟斤拷锟劫凤拷锟斤拷锟斤拷锟斤拷  0:锟斤拷锟斤拷 1:锟斤拷锟斤拷 2:S锟斤拷锟斤拷
#define START_OPEN_LOOP_STABLE_NUM      30      // 锟斤拷锟斤拷锟斤拷锟斤拷锟斤拷卸锟斤拷锟斤拷锟斤拷倩锟斤拷锟斤拷谢锟斤拷锟街帮拷锟揭拷榷锟斤拷锟斤拷卸锟斤拷锟斤拷锟

// 锟斤拷锟斤拷锟轿ｏ拷锟叫伙拷锟斤拷锟街阶讹拷 (Closed-loop Switching)
#define START_SWITCH_MIN_RPM            500     // 锟斤拷小锟斤拷转RPM(锟斤拷锟斤拷)  锟斤拷锟节达拷值锟斤拷为锟斤拷锟斤拷锟斤拷转锟斤拷
#define START_SWITCH_ZC_NUM             6       // 锟斤拷锟斤拷锟斤拷谢锟斤拷锟斤拷锟斤拷纬锟斤拷霉锟斤拷锟斤拷藕糯锟斤拷锟
#define START_SWITCH_ZC_MAX_ERR         30      // 锟斤拷锟斤拷藕锟斤拷锟斤拷锟斤拷蟛ǘ锟斤拷锟斤拷(%)  锟斤拷小说锟斤拷锟斤拷锟阶拷锟斤拷榷锟

// 锟斤拷锟斤拷锟斤拷锟斤拷占锟秸憋拷锟斤拷锟斤拷
#define START_DUTY_RAMP_STEP            5       // 每锟轿革拷锟斤拷锟秸颊憋拷锟斤拷锟接诧拷锟斤拷
#define START_DUTY_RAMP_PERIOD          5       // 占锟秸憋拷锟斤拷锟斤拷锟斤拷频锟斤拷(ms)






#endif
