vif802/stc32ESC/(commit log)

2026-03-10 Initial commit: STC32G BLDC motor controller project
    [无刷驱动-STC-无感-Lite3S.PcbLib, 无刷驱动-STC-无感-Lite3S.SchLib]
2026-03-10 Fix: Rename Project/CODE/motor.* to car_motor.* to avoid naming conflict with bldc/motor.*
    - Renamed motor.c -> car_motor.c
    - Renamed motor.h -> car_motor.h
    - Updated include guard in car_motor.h: _motor_h -> _car_motor_h
    - Added #include car_motor.h in car_ctrl.c
    This resolves the file naming conflict that could cause linking errors.
    [car_ctrl.c, car_motor.h]
2026-03-10 Fix: Adjust dead-time delay for 33.1776MHz system clock
    - Changed delay_500ns() from 8 nop to 18 nop
    - 33.1776MHz: 1 cycle ≈ 30ns, 18 cycles ≈ 540ns
    - Original code assumed 16MHz (62.5ns/cycle)
    - Prevents shoot-through and MOSFET damage
    [pwm.c]
2026-03-10 Fix: Prevent division by zero in PWM ISR
    - Added divisor variable declaration at block start (C251 requirement)
    - Check divisor > 0 before division to prevent runtime exception
    - Prevents crash when max+min < 2
    [motor.c]
2026-03-10 Fix: Allow motor stop in any running phase
    - Changed stop condition from (run_flag==3||4) to (run_flag!=0)
    - Motor now stops immediately when throttle goes to zero
    - Improves safety by allowing emergency stop during startup
    [pit_timer.c]
2026-03-19 Add project documentation and comprehensive README
    - Add README.md with complete project overview
    - Add BLDC project analysis report
    - Update BLDC driver modules (motor, pwm, comparator, pwm_input, battery, pit_timer)
    - Update libraries and peripherals
    - Add isr.c/h for interrupt handling
2026-03-19 Fix: Correct PWM input frequency range to 50-300Hz
    Per project requirements:
    - Change lower bound from 30Hz to 50Hz
    - Change upper bound from 400Hz to 300Hz
    [pwm_input.c]
2026-03-19 Docs: Add woring.md to track known code issues
